kosaku-oshima/vibe-compass/v0.3_autonomous_north_detection.ino/配置B.jpg

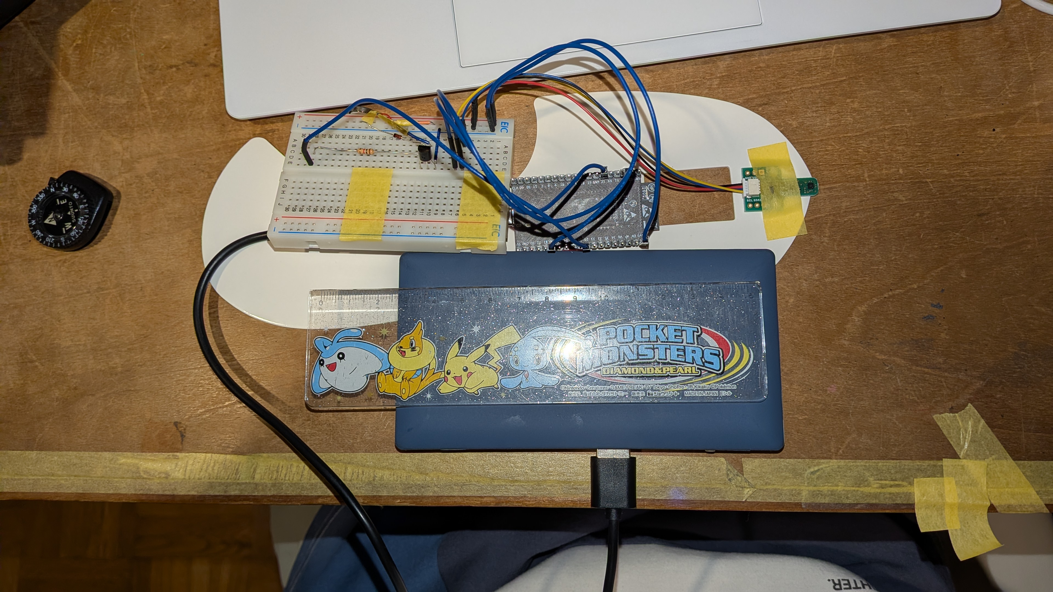
v0.3_autonomous_north_detection.ino/配置B.jpg
