kosaku-oshima/vibe-compass/(commit log)

2026-07-03 Add wiring memo and update README for v0.1
2026-07-05 北に近づくほど振動の間隔が短くなるよう修正
2026-07-05 v0.3 PCなし北検知版
2026-07-05 READMEを整理
2026-07-05 屋外テストの結果を受けて値を補正、README追記
2026-07-05 部品配置の決定し値を修正
2026-11-03 Rename v0.1 北検知＋振動成功版.ino to old/v0.1 北検知＋振動成功版.ino
